ayourk/MicroCoreLabs-Projects/EPROM_Emulator/PCB/ROM_Emulator.pdf

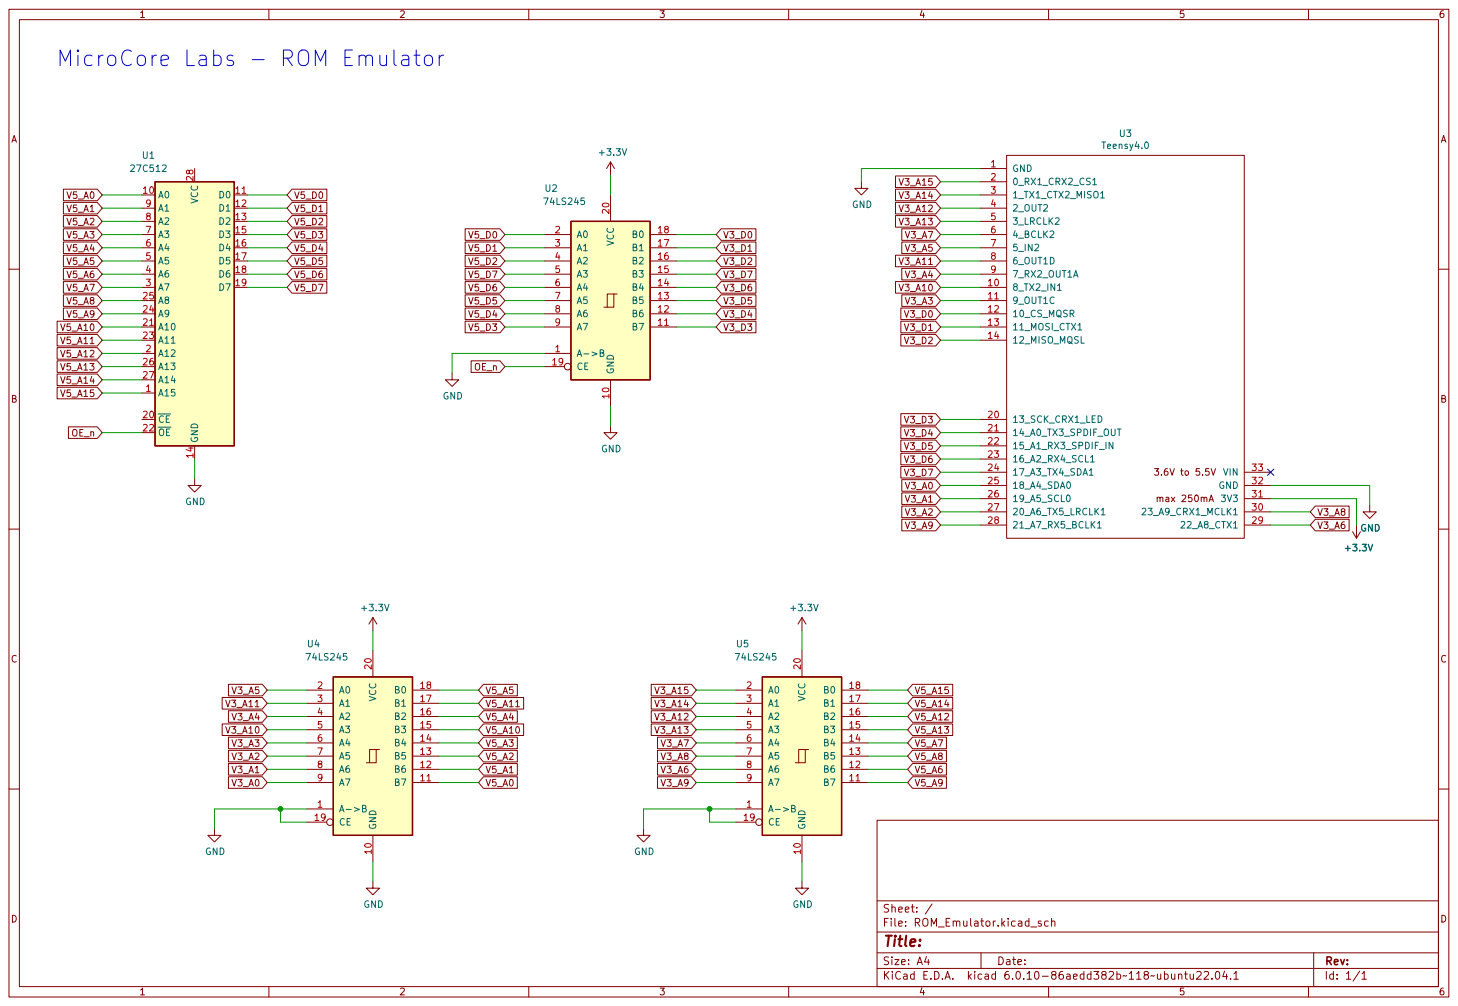
[picture p3: page 1]
