ayourk/MicroCoreLabs-Projects/EPROM_Emulator/PCB/ROM_Emulator.kicad_pcb

## KiCad design EPROM_Emulator/PCB/ROM_Emulator.kicad_pcb (2023-02-06)

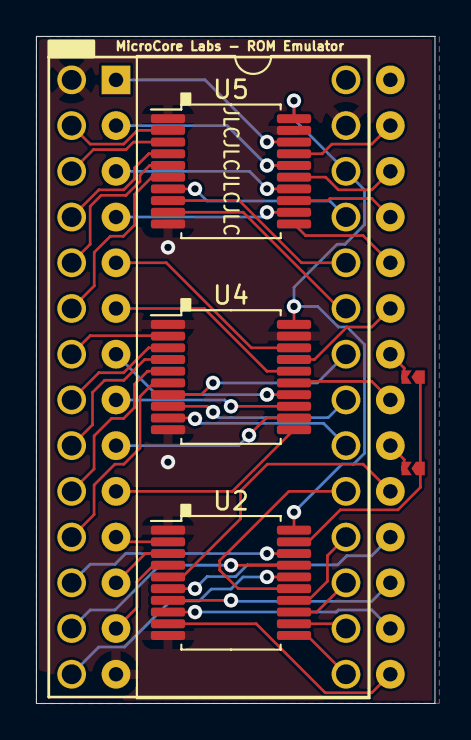
[picture p4: board ROM_Emulator.kicad_pcb from above]

Board: 2 copper layers, 22.1 x 37.1 mm, 7 parts (0 on the bottom side), 53 nets.

Parts:
REF_D9, REF_D9#2: SolderJumper-2_P1.3mm_Open_TrianglePad1.0x0.75mm
U1: 27C512; DIP-28_W15.24mm
U2, U4, U5: 74LS245; SSOP-20_5.3x7.2mm_P0.65mm
U3: Teensy4.0; Teensy40

Connections:
+3V3: U2.20 (VCC), U3.31 (3V3), U4.20 (VCC), U5.20 (VCC)
CS_20: REF_D9.2, U1.20 (~CE)
CS_22: REF_D9#2.2, U1.22 (~OE)
GND: U1.14 (GND), U2.1 (A->B), U2.10 (GND), U3.1 (GND), U3.32 (GND), U4.1 (A->B), U4.10 (GND), U4.19 (CE), U5.1 (A->B), U5.10 (GND), U5.19 (CE)
OE_n: REF_D9.1, REF_D9#2.1, U2.19 (CE)
V3_A0: U3.25 (18_A4_SDA0), U4.9 (A7)
V3_A1: U3.26 (19_A5_SCL0), U4.8 (A6)
V3_A2: U3.27 (20_A6_TX5_LRCLK1), U4.7 (A5)
V3_A3: U3.11 (9_OUT1C), U4.6 (A4)
V3_A4: U3.9 (7_RX2_OUT1A), U4.4 (A2)
V3_A5: U3.7 (5_IN2), U4.2 (A0)
V3_A6: U3.29 (22_A8_CTX1), U5.8 (A6)
V3_A7: U3.6 (4_BCLK2), U5.6 (A4)
V3_A8: U3.30 (23_A9_CRX1_MCLK1), U5.7 (A5)
V3_A9: U3.28 (21_A7_RX5_BCLK1), U5.9 (A7)
V3_A10: U3.10 (8_TX2_IN1), U4.5 (A3)
V3_A11: U3.8 (6_OUT1D), U4.3 (A1)
V3_A12: U3.4 (2_OUT2), U5.4 (A2)
V3_A13: U3.5 (3_LRCLK2), U5.5 (A3)
V3_A14: U3.3 (1_TX1_CTX2_MISO1), U5.3 (A1)
V3_A15: U3.2 (0_RX1_CRX2_CS1), U5.2 (A0)
V3_D0: U2.18 (B0), U3.12 (10_CS_MQSR)
V3_D1: U2.17 (B1), U3.13 (11_MOSI_CTX1)
V3_D2: U2.16 (B2), U3.14 (12_MISO_MQSL)
V3_D3: U2.11 (B7), U3.20 (13_SCK_CRX1_LED)
V3_D4: U2.12 (B6), U3.21 (14_A0_TX3_SPDIF_OUT)
V3_D5: U2.13 (B5), U3.22 (15_A1_RX3_SPDIF_IN)
V3_D6: U2.14 (B4), U3.23 (16_A2_RX4_SCL1)
V3_D7: U2.15 (B3), U3.24 (17_A3_TX4_SDA1)
V5_A0: U1.10 (A0), U4.11 (B7)
V5_A1: U1.9 (A1), U4.12 (B6)
V5_A2: U1.8 (A2), U4.13 (B5)
V5_A3: U1.7 (A3), U4.14 (B4)
V5_A4: U1.6 (A4), U4.16 (B2)
V5_A5: U1.5 (A5), U4.18 (B0)
V5_A6: U1.4 (A6), U5.12 (B6)
V5_A7: U1.3 (A7), U5.14 (B4)
V5_A8: U1.25 (A8), U5.13 (B5)
V5_A9: U1.24 (A9), U5.11 (B7)
V5_A10: U1.21 (A10), U4.15 (B3)
V5_A11: U1.23 (A11), U4.17 (B1)
V5_A12: U1.2 (A12), U5.16 (B2)
V5_A13: U1.26 (A13), U5.15 (B3)
V5_A14: U1.27 (A14), U5.17 (B1)
V5_A15: U1.1 (A15), U5.18 (B0)
V5_D0: U1.11 (D0), U2.2 (A0)
V5_D1: U1.12 (D1), U2.3 (A1)
V5_D2: U1.13 (D2), U2.4 (A2)
V5_D3: U1.15 (D3), U2.9 (A7)
V5_D4: U1.16 (D4), U2.8 (A6)
V5_D5: U1.17 (D5), U2.7 (A5)
V5_D6: U1.18 (D6), U2.6 (A4)
V5_D7: U1.19 (D7), U2.5 (A3)
