ayourk/MicroCoreLabs-Projects/(commit log)

2023-02-06 Move BOM to PCB root.
2023-02-06 Clarification about solder jumper locations.
2023-02-06 Updating BOM quantity.
2023-02-12 PDF of Schematic; Don't expect this to be up to date!
